DaniAntolin/TFG_DANI_ANTO/DEFINITIVO/diagramas_flujo/boton_diagram.drawio.png

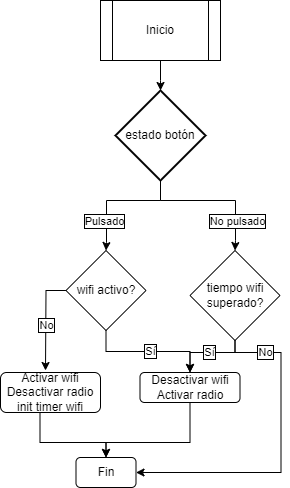
DEFINITIVO/diagramas_flujo/boton_diagram.drawio.png
