DaniAntolin/TFG_DANI_ANTO/DEFINITIVO/diagramas_flujo/diagramradio.png

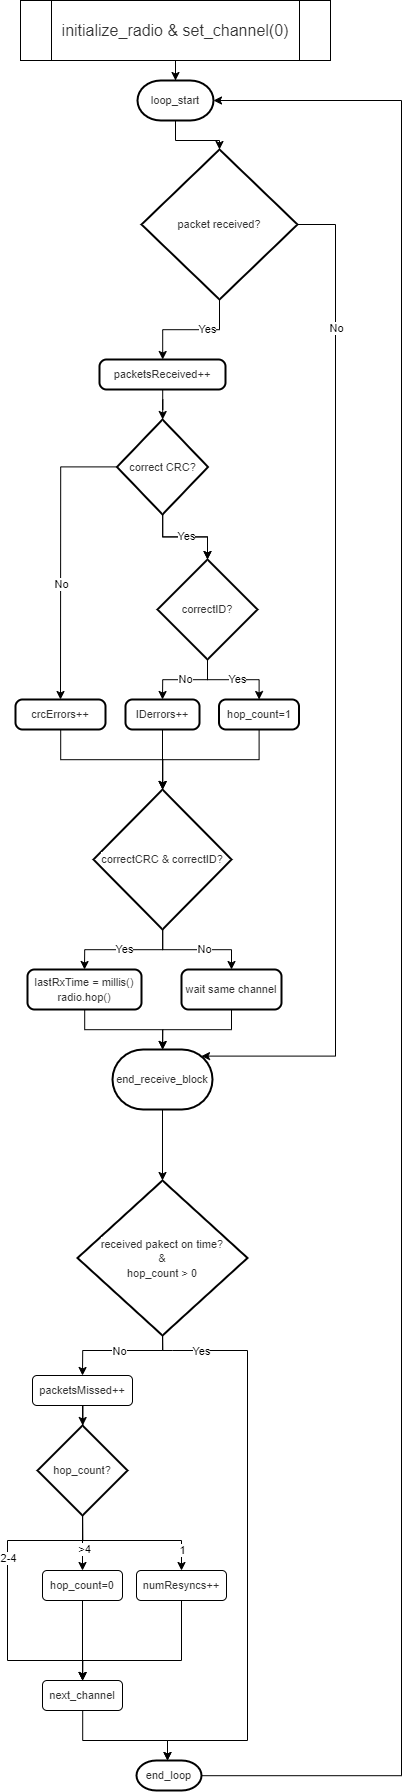
DEFINITIVO/diagramas_flujo/diagramradio.png
