DaniAntolin/TFG_DANI_ANTO/DEFINITIVO/diagramas_flujo/diagramtot.png

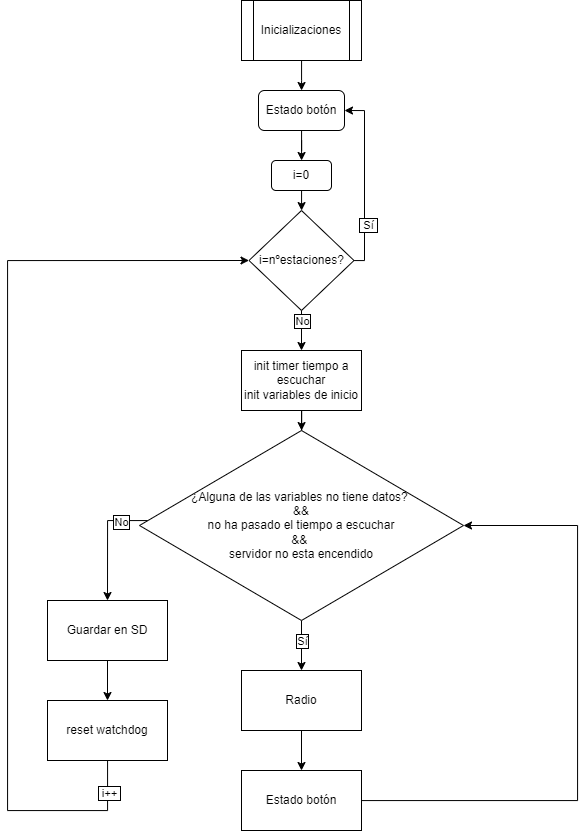
DEFINITIVO/diagramas_flujo/diagramtot.png
