DaniAntolin/TFG_DANI_ANTO/FOTOS/antena.JPG

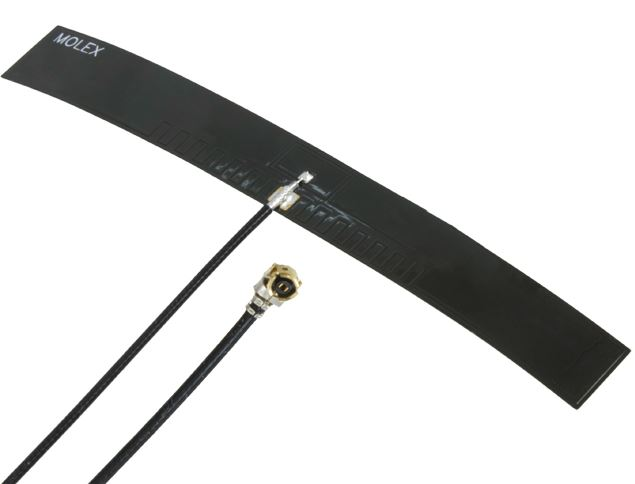
FOTOS/antena.JPG
