DaniAntolin/TFG_DANI_ANTO/FOTOS/batería y panel solar.JPG

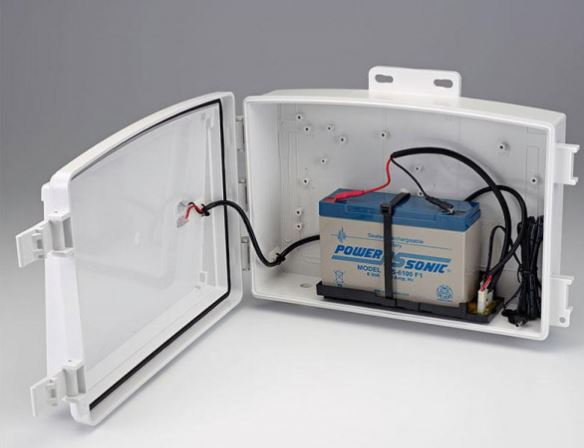
FOTOS/batería y panel solar.JPG
