DaniAntolin/TFG_DANI_ANTO/FOTOS/captura_sdr_sharp/2emisoras emitiendo.PNG

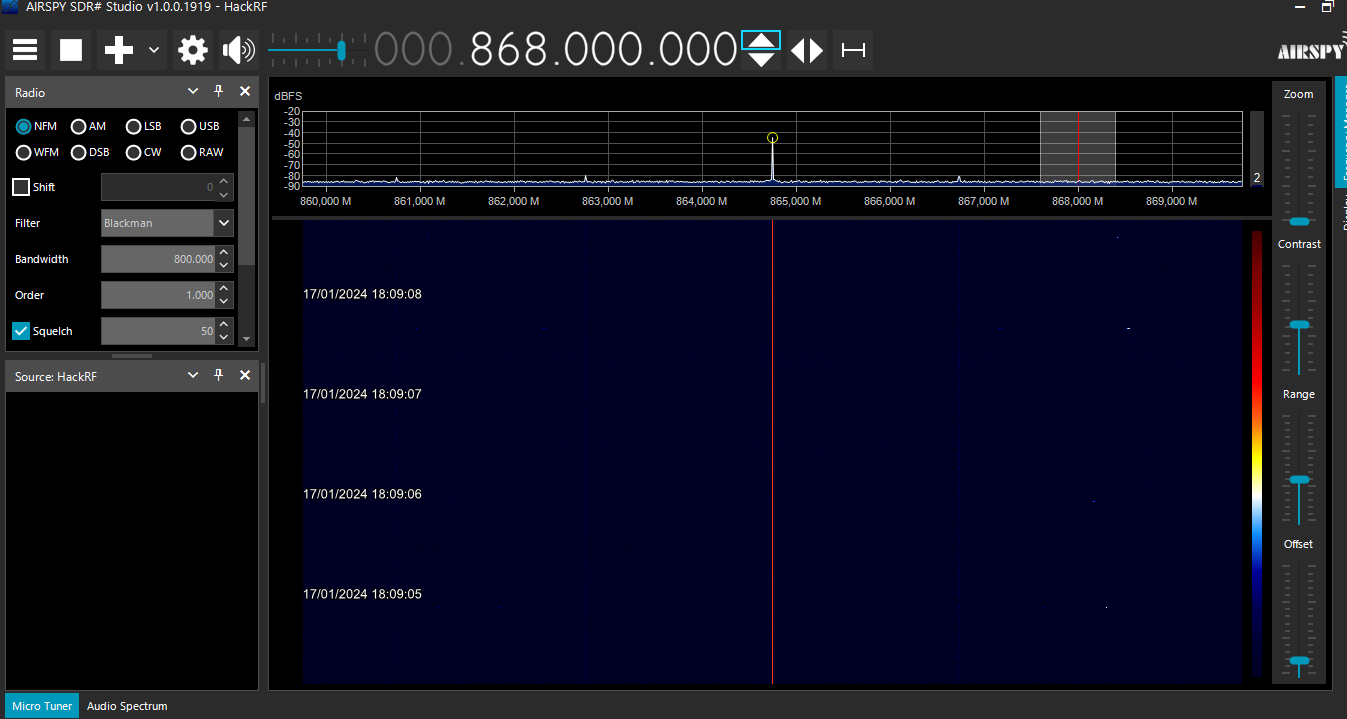
FOTOS/captura_sdr_sharp/2emisoras emitiendo.PNG
