DaniAntolin/TFG_DANI_ANTO/FOTOS/captura_sdr_sharp/5frecuencias, fhss, aleatorio.PNG

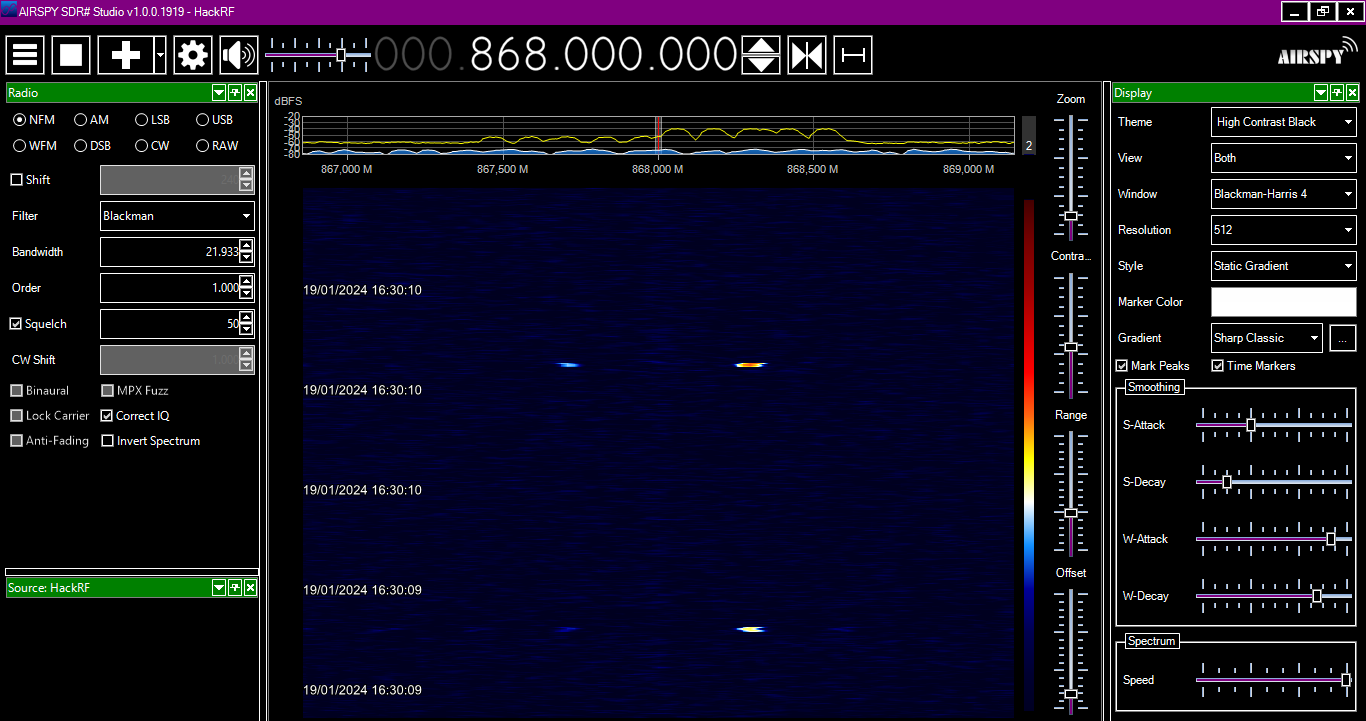
FOTOS/captura_sdr_sharp/5frecuencias, fhss, aleatorio.PNG
