DaniAntolin/TFG_DANI_ANTO/FOTOS/captura_sdr_sharp/Captura_bandacero.PNG

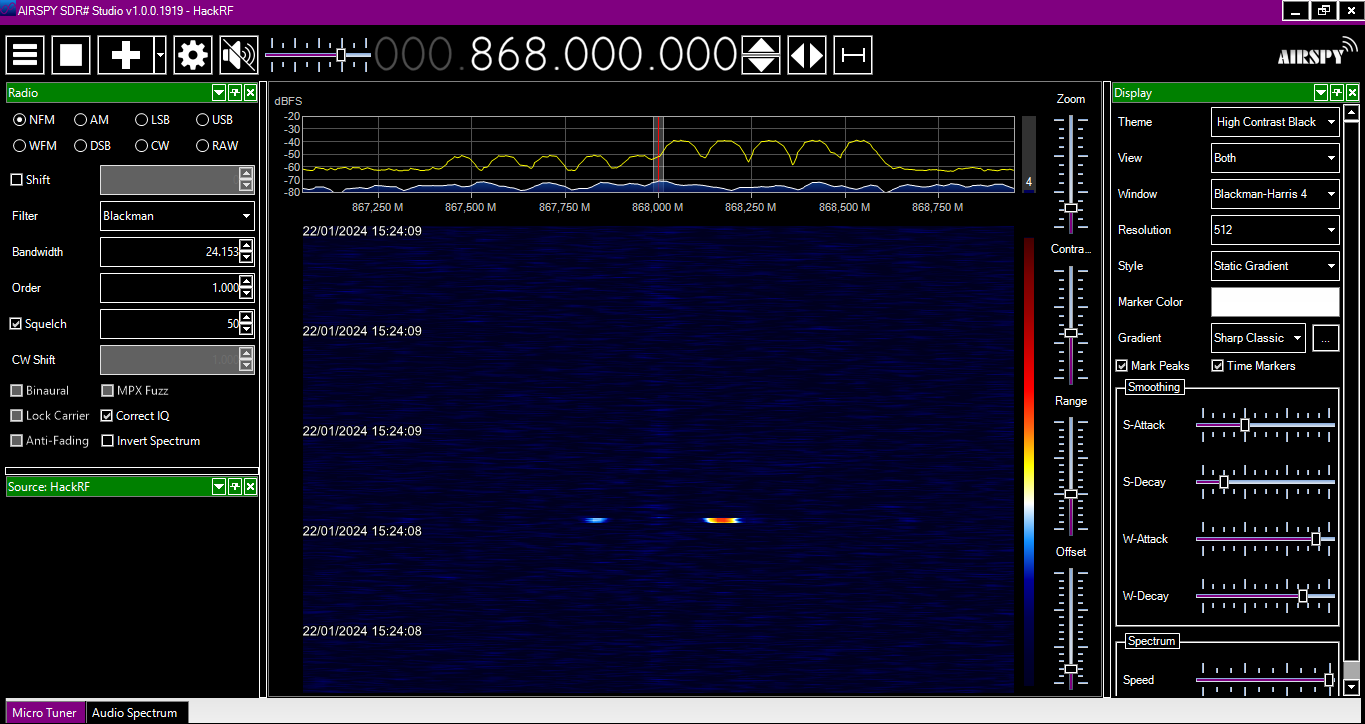
FOTOS/captura_sdr_sharp/Captura_bandacero.PNG
