DaniAntolin/TFG_DANI_ANTO/FOTOS/captura_sdr_sharp/Captura_cuartabanda.PNG

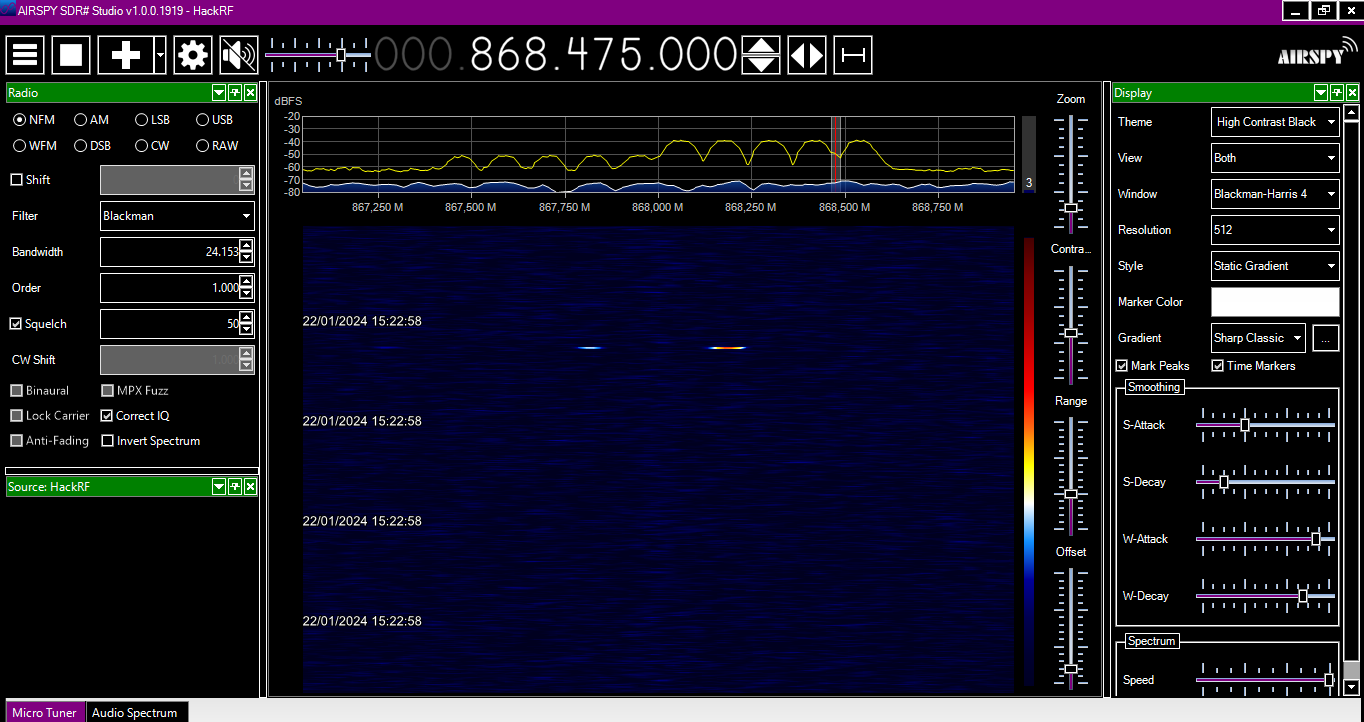
FOTOS/captura_sdr_sharp/Captura_cuartabanda.PNG
