DaniAntolin/TFG_DANI_ANTO/FOTOS/captura_sdr_sharp/Captura_segundabanda.PNG

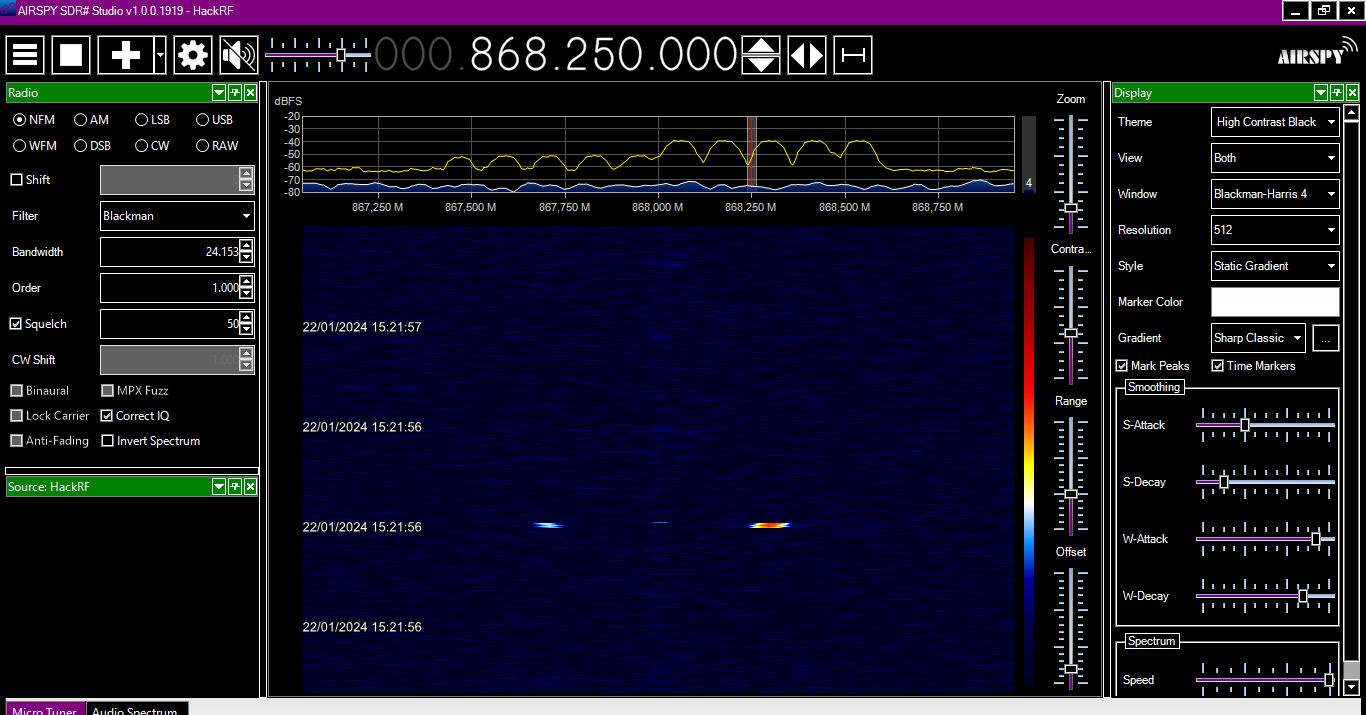
FOTOS/captura_sdr_sharp/Captura_segundabanda.PNG
