DaniAntolin/TFG_DANI_ANTO/FOTOS/captura_sdr_sharp/Captura_tercerabanda.PNG

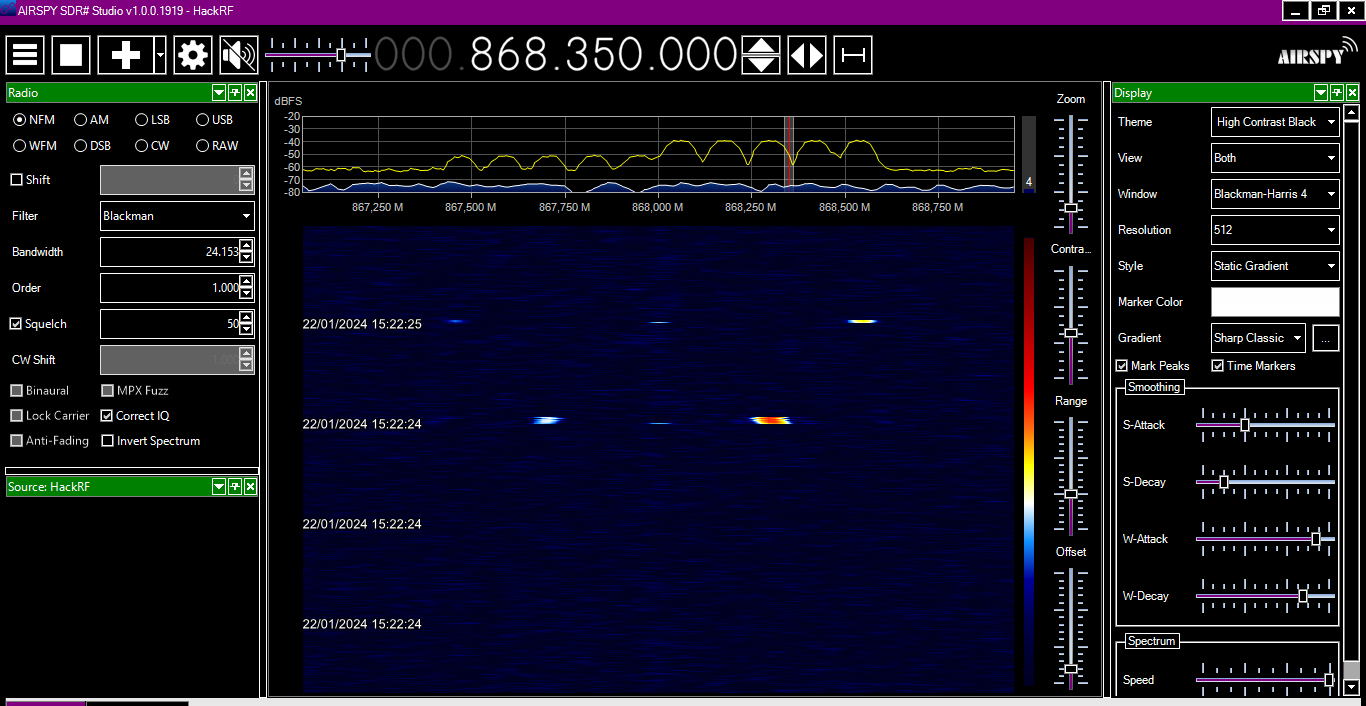
FOTOS/captura_sdr_sharp/Captura_tercerabanda.PNG
