DaniAntolin/TFG_DANI_ANTO/FOTOS/captura_sdr_sharp/capturagnu2misoaswaterfall.PNG

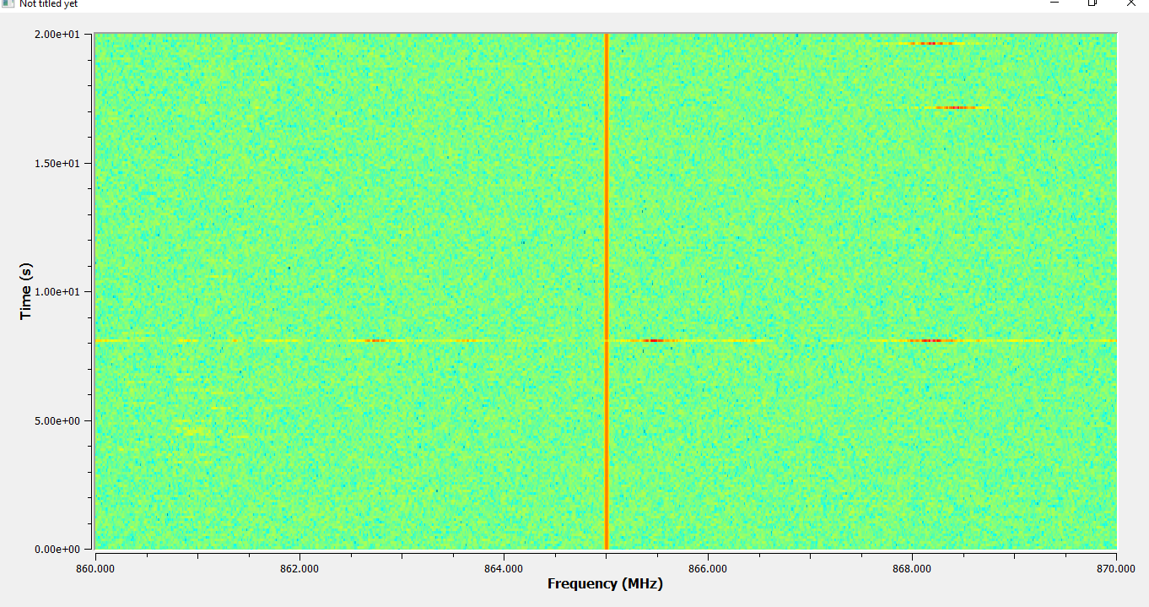
FOTOS/captura_sdr_sharp/capturagnu2misoaswaterfall.PNG
