DaniAntolin/TFG_DANI_ANTO/FOTOS/captura_sdr_sharp/Cerca2.JPG

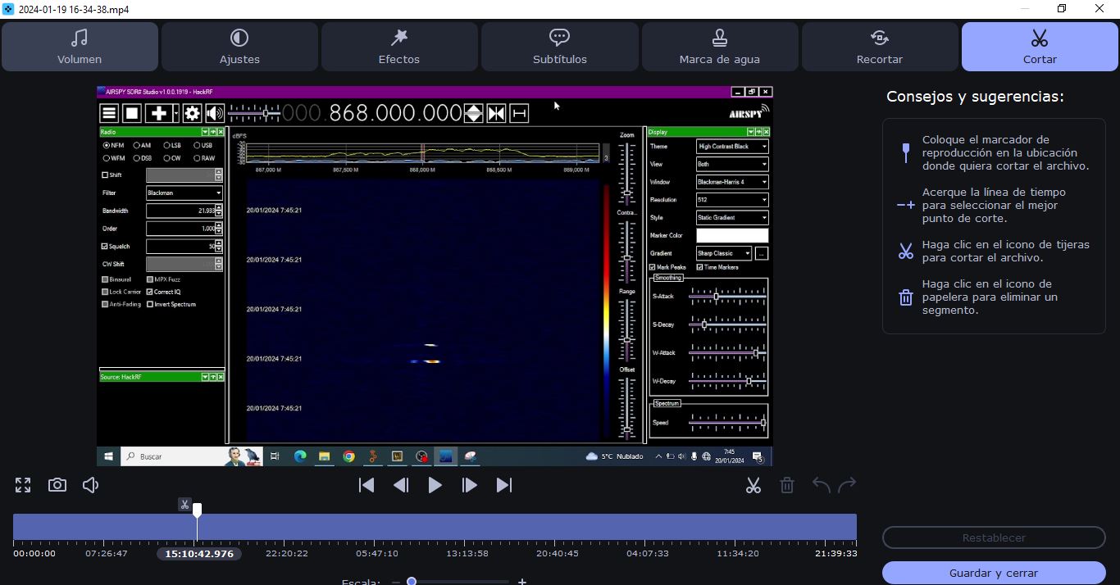
FOTOS/captura_sdr_sharp/Cerca2.JPG
