DaniAntolin/TFG_DANI_ANTO/FOTOS/captura_sdr_sharp/cerca3.JPG

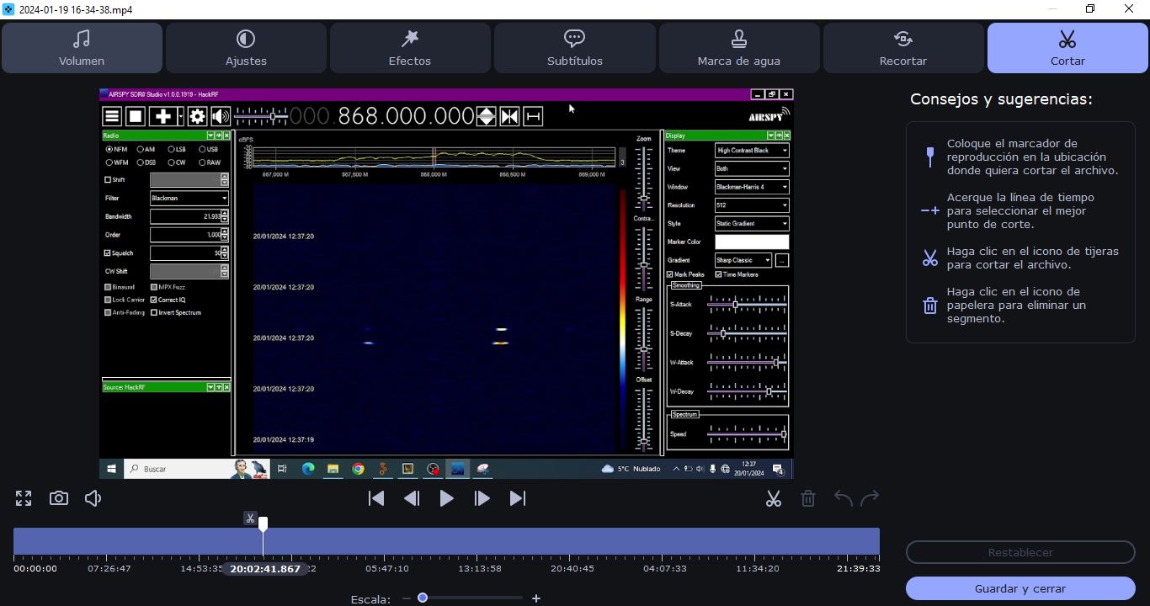
FOTOS/captura_sdr_sharp/cerca3.JPG
