DaniAntolin/TFG_DANI_ANTO/FOTOS/captura_sdr_sharp/cerca6.JPG

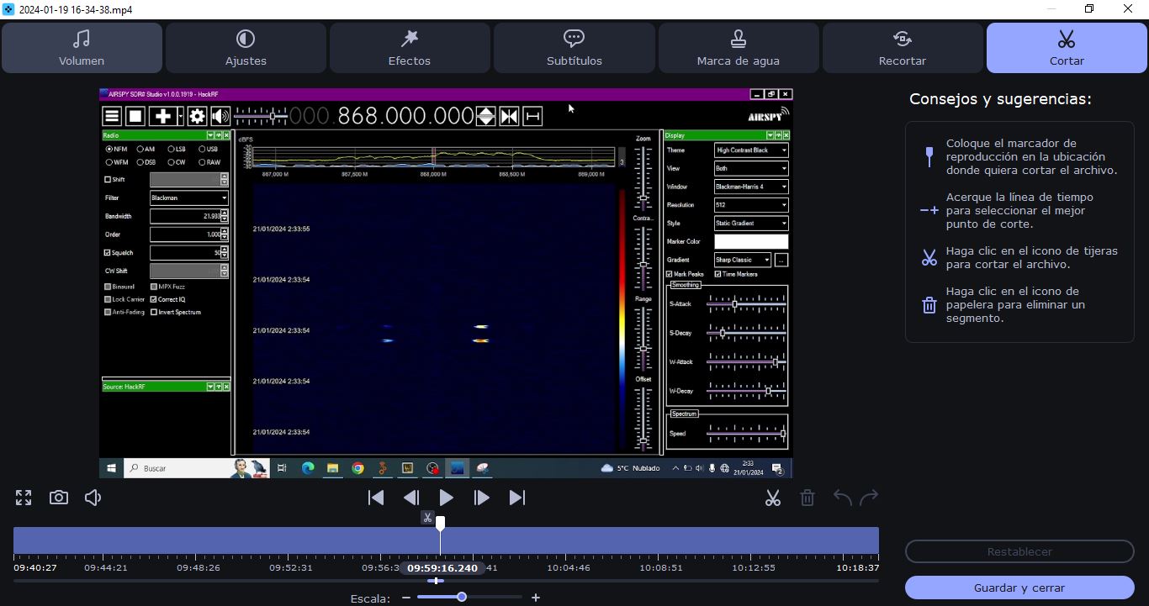
FOTOS/captura_sdr_sharp/cerca6.JPG
