DaniAntolin/TFG_DANI_ANTO/FOTOS/error_nose sincronizabien_WifiV1.JPG

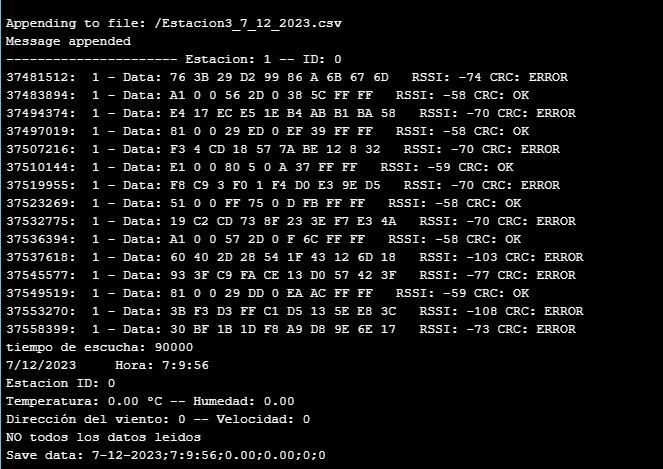
FOTOS/error_nose sincronizabien_WifiV1.JPG
