DaniAntolin/TFG_DANI_ANTO/FOTOS/NodoIoT_BOTON.jpg

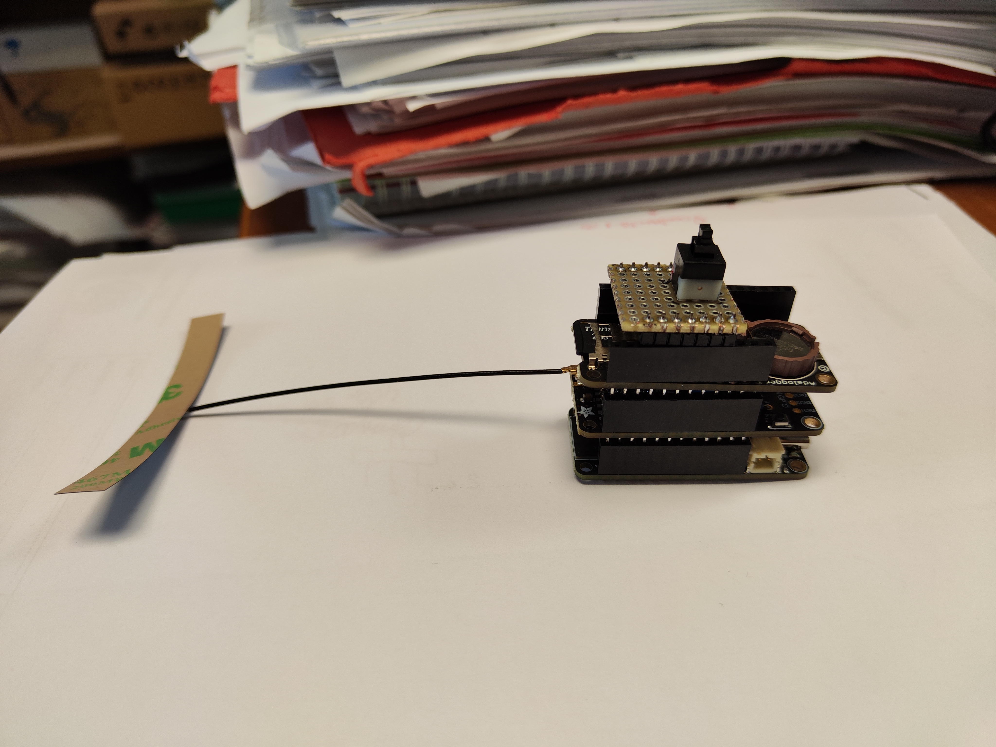
FOTOS/NodoIoT_BOTON.jpg
