DaniAntolin/TFG_DANI_ANTO/ESTADISTICAS/estadisticas_radio/pruebas 23-24 noviembre.html

# Pruebas 23-24 de noviembre

## Código ISSR modificado

## Pruebas 2 estaciones

- Midiendo de estación ID=1 y otra estación ID=2

x

14725225:  Hopped channel and ready to receive.

packetsReceived: 4840 packetsMissed: 519 numResyncs: 205 crcErrors: 302 idErrors: 512

  - Tiempo transcurrido: 14725225 ms
  - Paquetes posibles (teóricos): 14725225/(2563+(1/16)) = 5745
  - Paquetes recibidos: 4840
  - Paquetes que se deberían haber recibido (recibidos + missed) : 4840+519=5.359
  - Resincronizaciones: 205 (cada resincronización ha requerido en promedio 2,53 hops con sus correspondientes esperas)
  - Errores de CRC: 302
  - Errores de ID: 512
  - Paquetes correctos: 4840 - 302 - 512 = 4026
  - Tasa (paquetes correctos / paquete que se deberían haber recibido): 4026/5.359=75%
- Midiendo de estación ID=1 y la otra estación con ID=6

x

packetsReceived: 1301 packetsMissed: 106 numResyncs: 45 receivedStreak: 66 crcErrors: 68 idErrors: 156

3894281:  0 - Data: E1 0 0 80 5 0 A 37 FF FF   RSSI: -53 CRC: OK

  - Tiempo transcurrido: 3894281 ms
  - Paquetes posibles (teóricos): 3894281/(2563+(1/16)) = 1519
  - Paquetes recibidos: 1301
  - Paquetes que se deberían haber recibido (recibidos + missed) : 1301+106=1407
  - Resincronizaciones: 45 (cada resincronización ha requerido en promedio 2,35 hops con sus correspondientes esperas)
  - Errores de CRC: 68
  - Errores de ID:156
  - Paquetes correctos:1301 - 68 - 156 = 1077
  - Tasa (paquetes correctos / paquete que se deberían haber recibido): 1077/1407=76,5%
- Repitiendo y dejando toda la noche

x

packetsReceived: 21205 packetsMissed: 2501 numResyncs: 975 receivedStreak: 66 crcErrors: 1483 idErrors: 2564

65581295

  - Tiempo transcurrido: 65581295 ms
  - Paquetes posibles (teóricos): 65581295/(2563+(1/16)) = 25587
  - Paquetes recibidos: 21205 (82%)
  - Paquetes que se deberían haber recibido (recibidos + missed) : 21205+2501=23.706
  - Resincronizaciones: 975 (cada resincronización ha requerido en promedio 2,56 hops con sus correspondientes esperas)
  - Errores de CRC: 1483 (6,9%)
  - Errores de ID: 2564 (12%)
  - Paquetes correctos: 21205 - 1483 - 2564 = 17158
  - Tasa (paquetes correctos / paquete que se deberían haber recibido): 17158/23706=72,3%

## Pruebas 3 estaciones

- ID=1 + ID=0, ID=6

xxxxxxxxxx

3706815:  3 - Data: E6 0 0 80 5 0 C2 76 FF FF   RSSI: -54 CRC: OK

:  Wrong Station ID or CRC waiting in the same channel

packetsReceived: 1194 packetsMissed: 139 numResyncs: 57 receivedStreak: 13 crcErrors: 160

 idErrors: 317

  - Tiempo transcurrido: 3706815 ms
  - Paquetes posibles (teóricos): 3706815/(2563+(1/16)) = 1446
  - Paquetes recibidos: 1194 (82%)
  - Paquetes que se deberían haber recibido según el código (recibidos + missed) :1194+139=1333
  - Resincronizaciones: 57 (cada resincronización ha requerido en promedio 2,43 hops con sus correspondientes esperas)
  - Errores de CRC: 160 (13,4%)
  - Errores de ID: 317 (26,5%)
  - Paquetes correctos: 1194 -160 - 317=717
  - Tasa (paquetes correctos / paquete que se deberían haber recibido): 717/1333 = 53%
- ID=1 + ID=0, ID=6 (toda la noche) --> pendiente
