DaniAntolin/TFG_DANI_ANTO/ESTADISTICAS/Consumo/Prueba_wifi_2.xls

Voltage-Current
Time | Voltage(V) | Current(A) | D+(V) | D-(V) | Date | Potencia(W)
09:38:07 | 5.1432 | 0.04124 | 2.63 | 0.33 | 2023-12-06 | 0.212105568 | Hay 3 estaciones el valor de potencia constante en 0.5w corresponde con la estación 3, la cual no se tiene y al no obtener ningun valor se queda sin hacer ningun sleep
09:38:08 | 5.1444 | 0.04124 | 2.67 | 0.32 | 2023-12-06 | 0.212155056
09:38:09 | 5.1438 | 0.04104 | 2.82 | 0.38 | 2023-12-06 | 0.211101552
09:38:10 | 5.0892 | 0.09661 | 2.64 | 0.21 | 2023-12-06 | 0.491667612
09:38:11 | 5.1442 | 0.04137 | 2.74 | 0.37 | 2023-12-06 | 0.212815554
09:38:12 | 5.1446 | 0.04083 | 2.66 | 0.46 | 2023-12-06 | 0.210054018 | El pico en 0.8W aproximadamente corresponde con las veces que se conecta al wifi, pulsando el botón. Esta toma de datos de potencia se ha hecho para un valor maximo teórico de tiempo en la red de 5seg, donde se puede ver la segunda, tercera y cuartas vez que se conecta a la red (segundo, tercer y cuarto pico en 0.8w) que supera los 5segundos teoricos, llegando a 50segundos. El primer pico si que se ha pulsado de nuevo el boton para que se desconectara de la red wifi. Tambien en el segundo pico se ha hecho comprobaciones en
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
