DaniAntolin/TFG_DANI_ANTO/ESTADISTICAS/Datos almacenados/Prueba2_recepcion_guardado_2estaciones_conreset.xlsx

Sheet: Estacion1_6_12_2023
2023-12-06 | 14:00:05 | 21.15 | 59 | 0 | 9
2023-12-06 | 14:01:40 | 21.17 | 59 | 0 | 9
2023-12-06 | 14:09:29 | 21.22 | 59 | 0 | 9
2023-12-06 | 14:11:55 | 21.22 | 59 | 0 | 9
2023-12-06 | 14:15:18 | 21.25 | 59 | 0 | 9
2023-12-06 | 14:19:14 | 0 | 59 | 0 | 9
2023-12-06 | 14:22:59 | 21.28 | 59 | 0 | 9
2023-12-06 | 14:25:33 | 21.3 | 59 | 0 | 9
2023-12-06 | 14:28:07 | 21.3 | 59 | 0 | 9
2023-12-06 | 14:31:32 | 21.31 | 59 | 0 | 9
2023-12-06 | 14:34:05 | 21.33 | 59 | 0 | 9
2023-12-06 | 14:36:39 | 21.31 | 59 | 0 | 9
2023-12-06 | 14:39:13 | 21.31 | 59 | 0 | 9
2023-12-06 | 14:41:49 | 21.28 | 59 | 0 | 9
2023-12-06 | 14:44:31 | 21.28 | 59 | 0 | 9
2023-12-06 | 14:46:54 | 21.28 | 59 | 0 | 9 | Err todo 0s | Error Temp | Error Hum | Error tot
2023-12-06 | 14:49:30 | 21.28 | 59 | 0 | 9 | 0 | 1 | 2 | 2
2023-12-06 | 14:52:02 | 21.33 | 59 | 0 | 9
2023-12-06 | 14:54:38 | 21.28 | 59 | 0 | 9
2023-12-06 | 14:58:00 | 21.33 | 59 | 0 | 9
2023-12-06 | 15:00:34 | 21.33 | 59 | 0 | 9
2023-12-06 | 15:03:08 | 21.33 | 59 | 0 | 9
2023-12-06 | 15:05:42 | 21.33 | 59 | 0 | 9
2023-12-06 | 15:08:39 | 21.33 | 59 | 0 | 9
2023-12-06 | 15:10:49 | 21.33 | 59 | 0 | 9
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
