DaniAntolin/TFG_DANI_ANTO/ESTADISTICAS/Datos almacenados/Prueba3_recepcion_guardado_2estaciones_tiempo_escucha_150s_envezde_90s.xlsx

Sheet: Estacion1_8_12_2023
2023-12-08 | 0:04:07 | 20.83 | 60 | 0 | 9
2023-12-08 | 0:07:32 | 20.83 | 60 | 0 | 9
2023-12-08 | 0:11:48 | 20.82 | 60 | 0 | 9
2023-12-08 | 0:15:26 | 20.78 | 60 | 0 | 9
2023-12-08 | 0:18:41 | 20.72 | 60 | 0 | 9
2023-12-08 | 0:23:46 | 20.74 | 60 | 0 | 9
2023-12-08 | 0:28:02 | 20.69 | 60 | 0 | 9
2023-12-08 | 0:31:27 | 20.67 | 60 | 0 | 9
2023-12-08 | 0:34:52 | 20.67 | 60 | 0 | 9
2023-12-08 | 0:38:19 | 20.67 | 60 | 0 | 9
2023-12-08 | 0:41:42 | 20.67 | 60 | 0 | 9
2023-12-08 | 0:45:58 | 20.67 | 60 | 0 | 9
2023-12-08 | 0:49:26 | 20.61 | 60 | 0 | 9
2023-12-08 | 0:52:51 | 20.56 | 60 | 0 | 9
2023-12-08 | 0:56:13 | 20.56 | 60 | 0 | 9
2023-12-08 | 1:00:30 | 20.56 | 60 | 0 | 9
2023-12-08 | 1:04:46 | 20.5 | 60 | 0 | 9
2023-12-08 | 1:08:11 | 20.53 | 60 | 0 | 9
2023-12-08 | 1:11:36 | 20.5 | 60 | 0 | 9
2023-12-08 | 1:15:01 | 20.5 | 60 | 0 | 9
2023-12-08 | 1:18:28 | 20.5 | 60 | 0 | 9
2023-12-08 | 1:22:04 | 20.44 | 60 | 0 | 9
2023-12-08 | 1:26:07 | 20.47 | 60 | 0 | 9
2023-12-08 | 1:29:35 | 20.44 | 60 | 0 | 9
2023-12-08 | 1:32:57 | 20.42 | 60 | 0 | 9
2023-12-08 | 1:37:13 | 20.39 | 60 | 0 | 9
2023-12-08 | 1:40:38 | 20.39 | 61 | 0 | 9
2023-12-08 | 1:44:14 | 20.33 | 61 | 0 | 9
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
