DaniAntolin/TFG_DANI_ANTO/ESTADISTICAS/Datos almacenados/Prueba4_recepcion_guardado_2estaciones_id2yid5_envezde_id1yid2_90seg.xlsx

Sheet: Estacion1_14_12_2023
2023-12-14 | 0:32:53 | 15.06 | 63 | 0 | 9
2023-12-14 | 0:34:41 | 15.61 | 64 | 0 | 9
2023-12-14 | 0:36:34 | 16.28 | 71 | 0 | 9
2023-12-14 | 0:38:11 | 16.94 | 71 | 0 | 9
2023-12-14 | 0:39:56 | 17.39 | 69 | 0 | 9
2023-12-14 | 0:40:49 | 17.67 | 68 | 0 | 9
2023-12-14 | 0:41:41 | 17.83 | 68 | 0 | 9
2023-12-14 | 0:43:23 | 18.08 | 67 | 0 | 9
2023-12-14 | 0:45:08 | 18.35 | 66 | 0 | 9
2023-12-14 | 0:46:53 | 18.58 | 66 | 0 | 9
2023-12-14 | 0:48:38 | 18.76 | 65 | 0 | 9
2023-12-14 | 0:49:31 | 18.83 | 65 | 0 | 9
2023-12-14 | 0:50:23 | 18.94 | 64 | 0 | 9
2023-12-14 | 0:51:16 | 19 | 64 | 0 | 9
2023-12-14 | 0:53:01 | 19.11 | 64 | 0 | 9
2023-12-14 | 0:54:04 | 19.11 | 64 | 0 | 9 | Err todo 0s | Error Temp | Error Hum | Error tot
2023-12-14 | 0:54:49 | 19.17 | 63 | 0 | 9 | 3 | 0 | 18 | 21
2023-12-14 | 0:56:31 | 19.25 | 63 | 0 | 9
2023-12-14 | 0:58:16 | 19.33 | 63 | 0 | 9
2023-12-14 | 1:00:01 | 19.39 | 63 | 0 | 9
2023-12-14 | 1:01:46 | 19.44 | 63 | 0 | 9
2023-12-14 | 1:02:39 | 19.44 | 62 | 0 | 9
2023-12-14 | 1:03:31 | 19.5 | 62 | 0 | 9
2023-12-14 | 1:04:26 | 19.5 | 62 | 0 | 9
2023-12-14 | 1:05:19 | 19.5 | 62 | 0 | 9
2023-12-14 | 1:06:19 | 19.56 | 62 | 0 | 9
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
