DaniAntolin/TFG_DANI_ANTO/ESTADISTICAS/Datos almacenados/Prueba5_recepcion_guardado_2estaciones_3dataloggers.xlsx

Sheet: Estacion1_DT2
2023-12-18 | 16:18:25 | 23.17 | 35 | 0 | 9
2023-12-18 | 16:19:32 | 23.22 | 35 | 0 | 9
2023-12-18 | 16:21:05 | 10.39 | 54 | 0 | 9
2023-12-18 | 16:22:47 | 10.39 | 55 | 0 | 9
2023-12-18 | 16:24:30 | 10.44 | 55 | 0 | 9
2023-12-18 | 16:26:22 | 10.5 | 55 | 0 | 9
2023-12-18 | 16:28:46 | 10.5 | 55 | 0 | 9
2023-12-18 | 16:30:29 | 10.56 | 55 | 0 | 9
2023-12-18 | 16:32:11 | 10.61 | 55 | 0 | 9
2023-12-18 | 16:34:06 | 10.61 | 55 | 0 | 9
2023-12-18 | 16:36:27 | 10.67 | 55 | 0 | 9
2023-12-18 | 16:38:10 | 10.67 | 56 | 0 | 9
2023-12-18 | 16:39:55 | 10.72 | 56 | 0 | 9
2023-12-18 | 16:41:35 | 10.72 | 56 | 0 | 9
2023-12-18 | 16:43:20 | 10.72 | 56 | 0 | 9
2023-12-18 | 16:45:02 | 10.72 | 56 | 0 | 9
2023-12-18 | 16:46:55 | 10.72 | 56 | 0 | 9
2023-12-18 | 16:48:35 | 10.72 | 56 | 0 | 9
2023-12-18 | 16:50:38 | 0 | 0 | 0 | 9
2023-12-18 | 16:51:50 | 10.67 | 56 | 0 | 9
2023-12-18 | 16:53:32 | 10.67 | 56 | 0 | 9
2023-12-18 | 16:55:56 | 0 | 0 | 0 | 0
2023-12-18 | 16:58:40 | 10.61 | 57 | 0 | 291
2023-12-18 | 17:01:34 | 10.61 | 0 | 0 | 287
2023-12-18 | 17:02:56 | 10.56 | 57 | 0 | 287
2023-12-18 | 17:05:22 | 10.56 | 0 | 0 | 287
2023-12-18 | 17:07:11 | 10.56 | 0 | 0 | 287
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
