DaniAntolin/TFG_DANI_ANTO/ESTADISTICAS/Datos almacenados/Prueba_recepcion_guardado_2estaciones.xlsx

Sheet: Estacion1_2_12_2023
2023-12-02 | 8:45:08 | 19.97 | 61 | 0 | 9
2023-12-02 | 8:46:40 | 19.97 | 61 | 0 | 9
2023-12-02 | 8:48:12 | 19.98 | 61 | 0 | 9
2023-12-02 | 8:49:33 | 20 | 61 | 0 | 9
2023-12-02 | 8:56:33 | 20.06 | 61 | 0 | 9
2023-12-02 | 9:03:46 | 20.06 | 61 | 0 | 9
2023-12-02 | 9:04:25 | 20.06 | 61 | 0 | 9
2023-12-02 | 9:05:18 | 20.06 | 61 | 0 | 9
2023-12-02 | 9:09:41 | 20.11 | 61 | 0 | 9
2023-12-02 | 9:10:33 | 20.11 | 61 | 0 | 9
2023-12-02 | 9:14:07 | 0 | 0 | 0 | 0
2023-12-02 | 8:14:16 | 19.69 | 62 | 0 | 9
2023-12-02 | 8:16:50 | 19.72 | 62 | 0 | 9
2023-12-02 | 8:20:32 | 0 | 0 | 0 | 0
2023-12-02 | 8:22:51 | 19.72 | 62 | 0 | 9
2023-12-02 | 8:26:01 | 19.72 | 0 | 0 | 9 | Err todo 0s | Error Temp | Error Hum | Error tot
2023-12-02 | 8:29:19 | 0 | 0 | 0 | 0 | 14 | 2 | 7 | 21
2023-12-02 | 8:32:13 | 19.72 | 62 | 0 | 9
2023-12-02 | 8:34:46 | 19.75 | 62 | 0 | 9
2023-12-02 | 8:37:30 | 19.78 | 62 | 0 | 9
2023-12-02 | 8:39:54 | 19.72 | 62 | 0 | 9
2023-12-02 | 8:43:19 | 19.78 | 62 | 0 | 9
2023-12-02 | 8:45:53 | 19.78 | 62 | 0 | 9
2023-12-02 | 8:48:27 | 19.78 | 62 | 0 | 9
2023-12-02 | 8:51:00 | 19.78 | 62 | 0 | 9
2023-12-02 | 8:53:37 | 19.83 | 62 | 0 | 9
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
