DaniAntolin/TFG_DANI_ANTO/ESTADISTICAS/Consumo/Prueba_wifi_1.xls

Voltage-Current
Time | Voltage(V) | Current(A) | D+(V) | D-(V) | Date | Potencia (W) | Hay 3 estaciones el valor de potencia constante en 0.5w corresponde con la estación 3, la cual no se tiene y al no obtener ningun valor se queda sin hacer ningun sleep
09:19:32 | 5.1158 | 0.04652 | 2.52 | 0.28 | 2023-12-06 | 0.237987016
09:19:33 | 4.9655 | 0.06692 | 2.73 | 0.29 | 2023-12-06 | 0.33229126
09:19:34 | 5.017 | 0.0464 | 2.87 | 0.51 | 2023-12-06 | 0.2327888
09:19:35 | 5.0251 | 0.05318 | 2.88 | 0.27 | 2023-12-06 | 0.267234818
09:19:36 | 5.0416 | 0.04673 | 2.62 | 0.19 | 2023-12-06 | 0.235593968 | El pico en 0.8W aproximadamente corresponde con las dos veces que se ha pulsado el boton y está conectado a la red wifi. Esta toma de datos de potencia se ha hecho para un valor maximo teórico de tiempo en la red de 5min, donde se puede ver la segunda vez que se conecta a la red (segundo pico en 0.8w) que supera los 5min teoricos. El primer pico si que se ha pulsado de nuevo el boton para que se desconectara de la red wifi.
09:19:37 | 5.0395 | 0.04631 | 2.8 | 0.33 | 2023-12-06 | 0.233379245
09:19:38 | 4.8958 | 0.10088 | 2.74 | 0.44 | 2023-12-06 | 0.493888304
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
