DaniAntolin/TFG_DANI_ANTO/ESTADISTICAS/Consumo/Prueba_wifi_3.xls

Voltage-Current
Time | Voltage(V) | Current(A) | D+(V) | D-(V) | Date | Potencia(W)
09:57:41 | 5.1179 | 0.0964 | 2.63 | 0.2 | 2023-12-06 | 0.49336556 | Aquí se prueba con 5minutos teoricos de tiempo maximo en la página web que, realmente supera el valor experimental este valor teórico. Ya que han pasado 6 min
09:57:42 | 5.1178 | 0.09627 | 2.6 | 0.26 | 2023-12-06 | 0.492690606
09:57:43 | 5.118 | 0.0964 | 2.77 | 0.17 | 2023-12-06 | 0.4933752
09:57:44 | 5.1181 | 0.09648 | 2.53 | 0.39 | 2023-12-06 | 0.493794288
09:57:45 | 5.118 | 0.09651 | 2.86 | 0.34 | 2023-12-06 | 0.49393818
09:57:46 | 5.1181 | 0.09652 | 2.65 | 0.38 | 2023-12-06 | 0.493999012
09:57:47 | 5.118 | 0.09669 | 2.95 | 0.37 | 2023-12-06 | 0.49485942
09:57:48 | 5.1179 | 0.09615 | 2.71 | 0.49 | 2023-12-06 | 0.492086085
09:57:49 | 5.1179 | 0.0964 | 2.76 | 0.33 | 2023-12-06 | 0.49336556
09:57:50 | 5.1179 | 0.09673 | 2.75 | 0.18 | 2023-12-06 | 0.495054467
09:57:51 | 5.118 | 0.09665 | 2.81 | 0.2 | 2023-12-06 | 0.4946547
09:57:52 | 5.1181 | 0.09627 | 2.63 | 0.49 | 2023-12-06 | 0.492719487
09:57:53 | 5.1181 | 0.09655 | 2.66 | 0.15 | 2023-12-06 | 0.494152555
09:57:54 | 5.118 | 0.09655 | 2.73 | 0.41 | 2023-12-06 | 0.4941429
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
