DaniAntolin/TFG_DANI_ANTO/ESTADISTICAS/Consumo/Prueba_wifi_4.xls

Voltage-Current
Time | Voltage(V) | Current(A) | D+(V) | D-(V) | Date | Potencia(W)
10:09:59 | 5.118 | 0.09816 | 2.68 | 0.29 | 2023-12-06 | 0.50238288 | Ahora se comprueba para 5min/10 teoricos corresponden aproximadamente a 5minutos reales
10:10:00 | 5.1179 | 0.09812 | 2.74 | 0.19 | 2023-12-06 | 0.502168348
10:10:01 | 5.1179 | 0.09789 | 2.62 | 0.56 | 2023-12-06 | 0.500991231
10:10:02 | 5.1177 | 0.0979 | 2.48 | 0.31 | 2023-12-06 | 0.50102283
10:10:03 | 5.1177 | 0.09792 | 2.64 | 0.24 | 2023-12-06 | 0.501125184
10:10:04 | 5.1177 | 0.09786 | 2.83 | 0.14 | 2023-12-06 | 0.500818122
10:10:05 | 5.157 | 0.04124 | 2.81 | 0.17 | 2023-12-06 | 0.21267468
10:10:06 | 5.157 | 0.04045 | 2.87 | 0.31 | 2023-12-06 | 0.20860065
10:10:07 | 5.1422 | 0.05502 | 2.74 | 0.32 | 2023-12-06 | 0.282923844
10:10:08 | 5.1571 | 0.04124 | 2.89 | 0.44 | 2023-12-06 | 0.212678804
10:10:09 | 5.1183 | 0.09707 | 2.62 | 0.17 | 2023-12-06 | 0.496833381
10:10:10 | 5.157 | 0.04099 | 2.52 | 0.18 | 2023-12-06 | 0.21138543
10:10:11 | 5.157 | 0.04037 | 2.75 | 0.4 | 2023-12-06 | 0.20818809
10:10:12 | 5.1233 | 0.07751 | 2.66 | 0.31 | 2023-12-06 | 0.397106983
10:10:13 | 5.1571 | 0.04124 | 2.78 | 0.31 | 2023-12-06 | 0.212678804
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
