DaniAntolin/TFG_DANI_ANTO/FOTOS/PruebasRadio/humedad39%.JPG

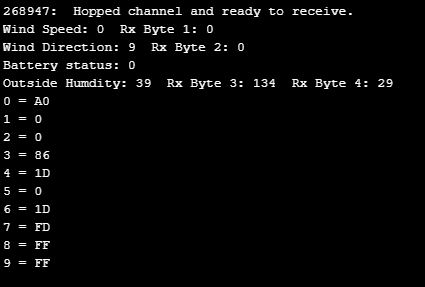
FOTOS/PruebasRadio/humedad39%.JPG
