DaniAntolin/TFG_DANI_ANTO/FOTOS/PruebasRadio/recepcion en Esp modificado 1.JPG

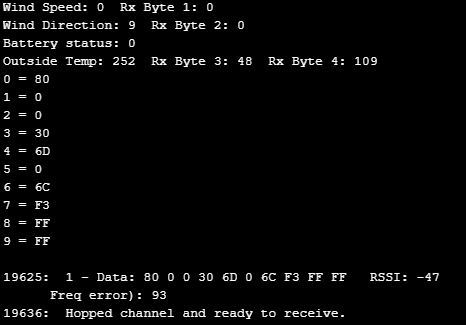
FOTOS/PruebasRadio/recepcion en Esp modificado 1.JPG
