DaniAntolin/TFG_DANI_ANTO/FOTOS/PruebasRadio/Recepcion en ISSRx ESP.JPG

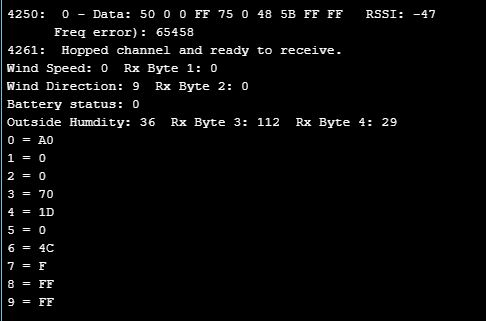
FOTOS/PruebasRadio/Recepcion en ISSRx ESP.JPG
