DaniAntolin/TFG_DANI_ANTO/ESTADISTICAS/Datos almacenados/todo_en_uno/DT1.png

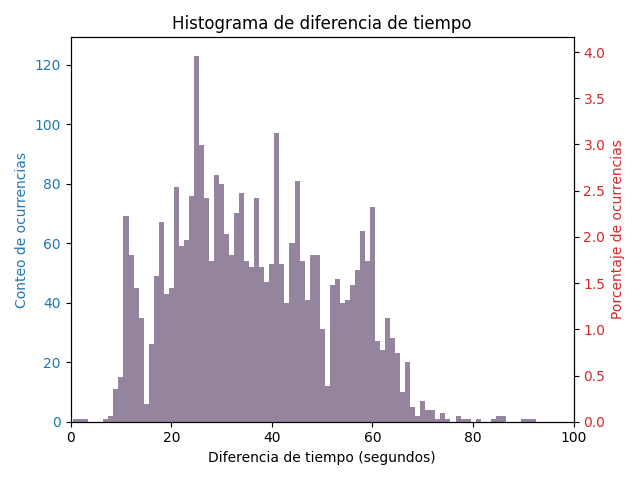
ESTADISTICAS/Datos almacenados/todo_en_uno/DT1.png
