DaniAntolin/TFG_DANI_ANTO/ESTADISTICAS/Datos almacenados/todo_en_uno/DT2.png

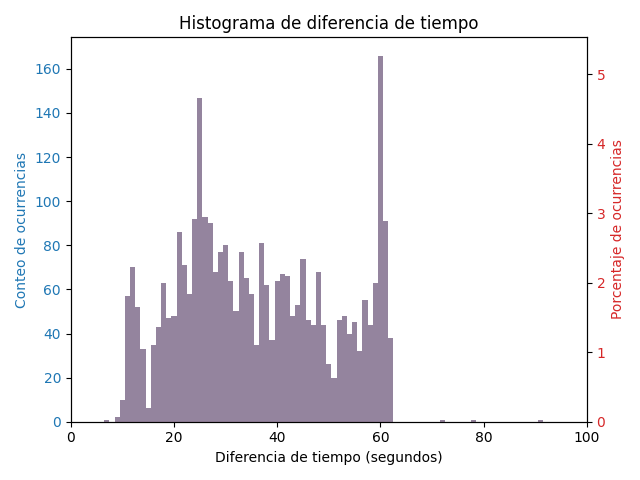
ESTADISTICAS/Datos almacenados/todo_en_uno/DT2.png
