DaniAntolin/TFG_DANI_ANTO/ESTADISTICAS/Datos almacenados/todo_en_uno/Expedición.png

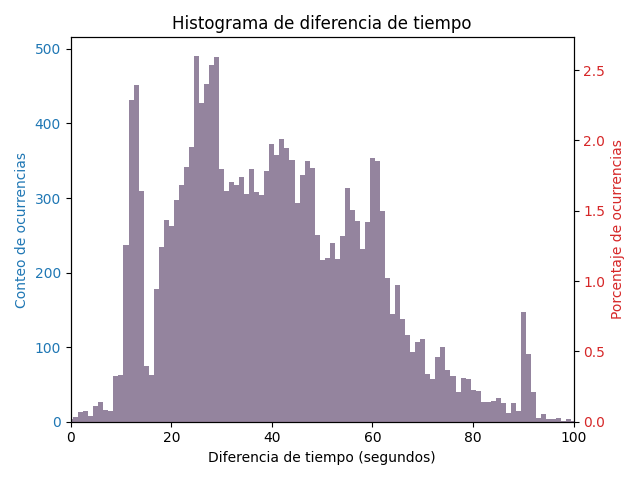
ESTADISTICAS/Datos almacenados/todo_en_uno/Expedición.png
