DaniAntolin/TFG_DANI_ANTO/ESTADISTICAS/Datos almacenados/todo_en_uno/Figure_1_P.png

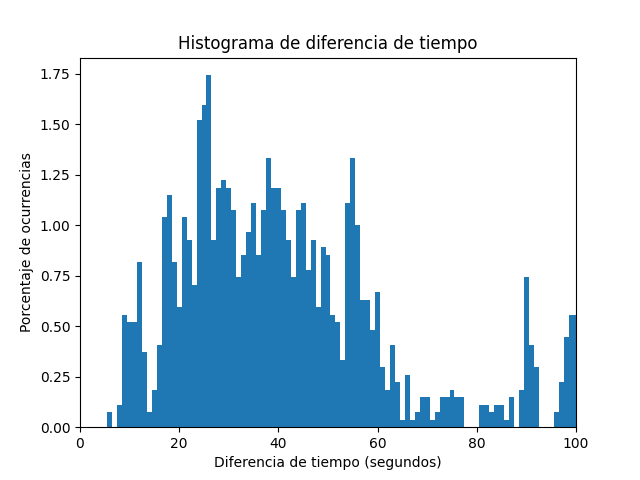
ESTADISTICAS/Datos almacenados/todo_en_uno/Figure_1_P.png
