DaniAntolin/TFG_DANI_ANTO/ESTADISTICAS/Datos almacenados/todo_en_uno/P2.png

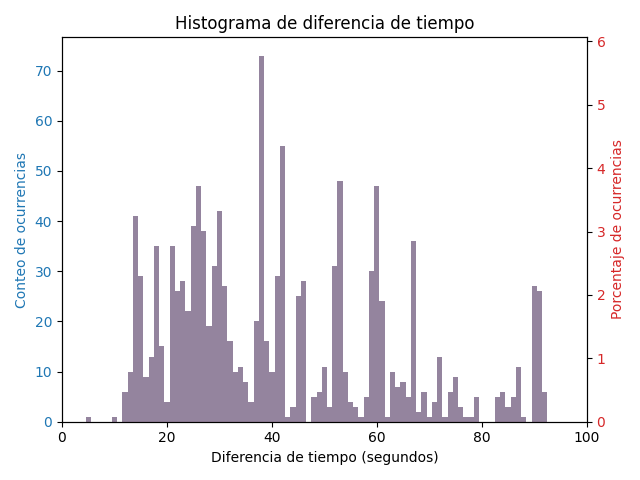
ESTADISTICAS/Datos almacenados/todo_en_uno/P2.png
