DaniAntolin/TFG_DANI_ANTO/(commit log)

2024-05-28 todo lo que queda
    [AWS_1m_1min_2024_03-12a14-SoloDT2.csv, AWS_1m_1min_2024_03-5a14-SoloDT1.csv, AWS_3m_1min_2024_03-12a14-SoloDT2.csv, AWS_3m_1min_2024_03-5a14-SoloDT1.csv, AWS_9m_1min_2024_03-12a14-soloDT2.csv, AWS_9m_1min_2024_03-5a14-soloDT1.csv, E1_DT1.csv, E1_DT2.csv]
2024-05-28 comit cambios
    [AWS_1m_1min_2024_03-12a14-SoloDT2.csv, AWS_1m_1min_2024_03-5a14-SoloDT1.csv, AWS_3m_1min_2024_03-12a14-SoloDT2.csv, AWS_3m_1min_2024_03-5a14-SoloDT1.csv, AWS_9m_1min_2024_03-12a14-soloDT2.csv, AWS_9m_1min_2024_03-5a14-soloDT1.csv, Estacion1_2024_03_05-DT1.csv, Estacion1_2024_03_06-DT1.csv]
